SunflareSolarteam/004-H-01-SD-card-data-logger-PCB/README.md

# 004-H-01-SD-card-data-logger-PCB
Data logger for logging CAN bus data on SD card in the Sunflare solar boat
