SunflareSolarteam/004-H-01-SD-card-data-logger-PCB/Project Outputs for 004-H-01 SD data logger/004-H-01 SD data logger_Documentation.PDF

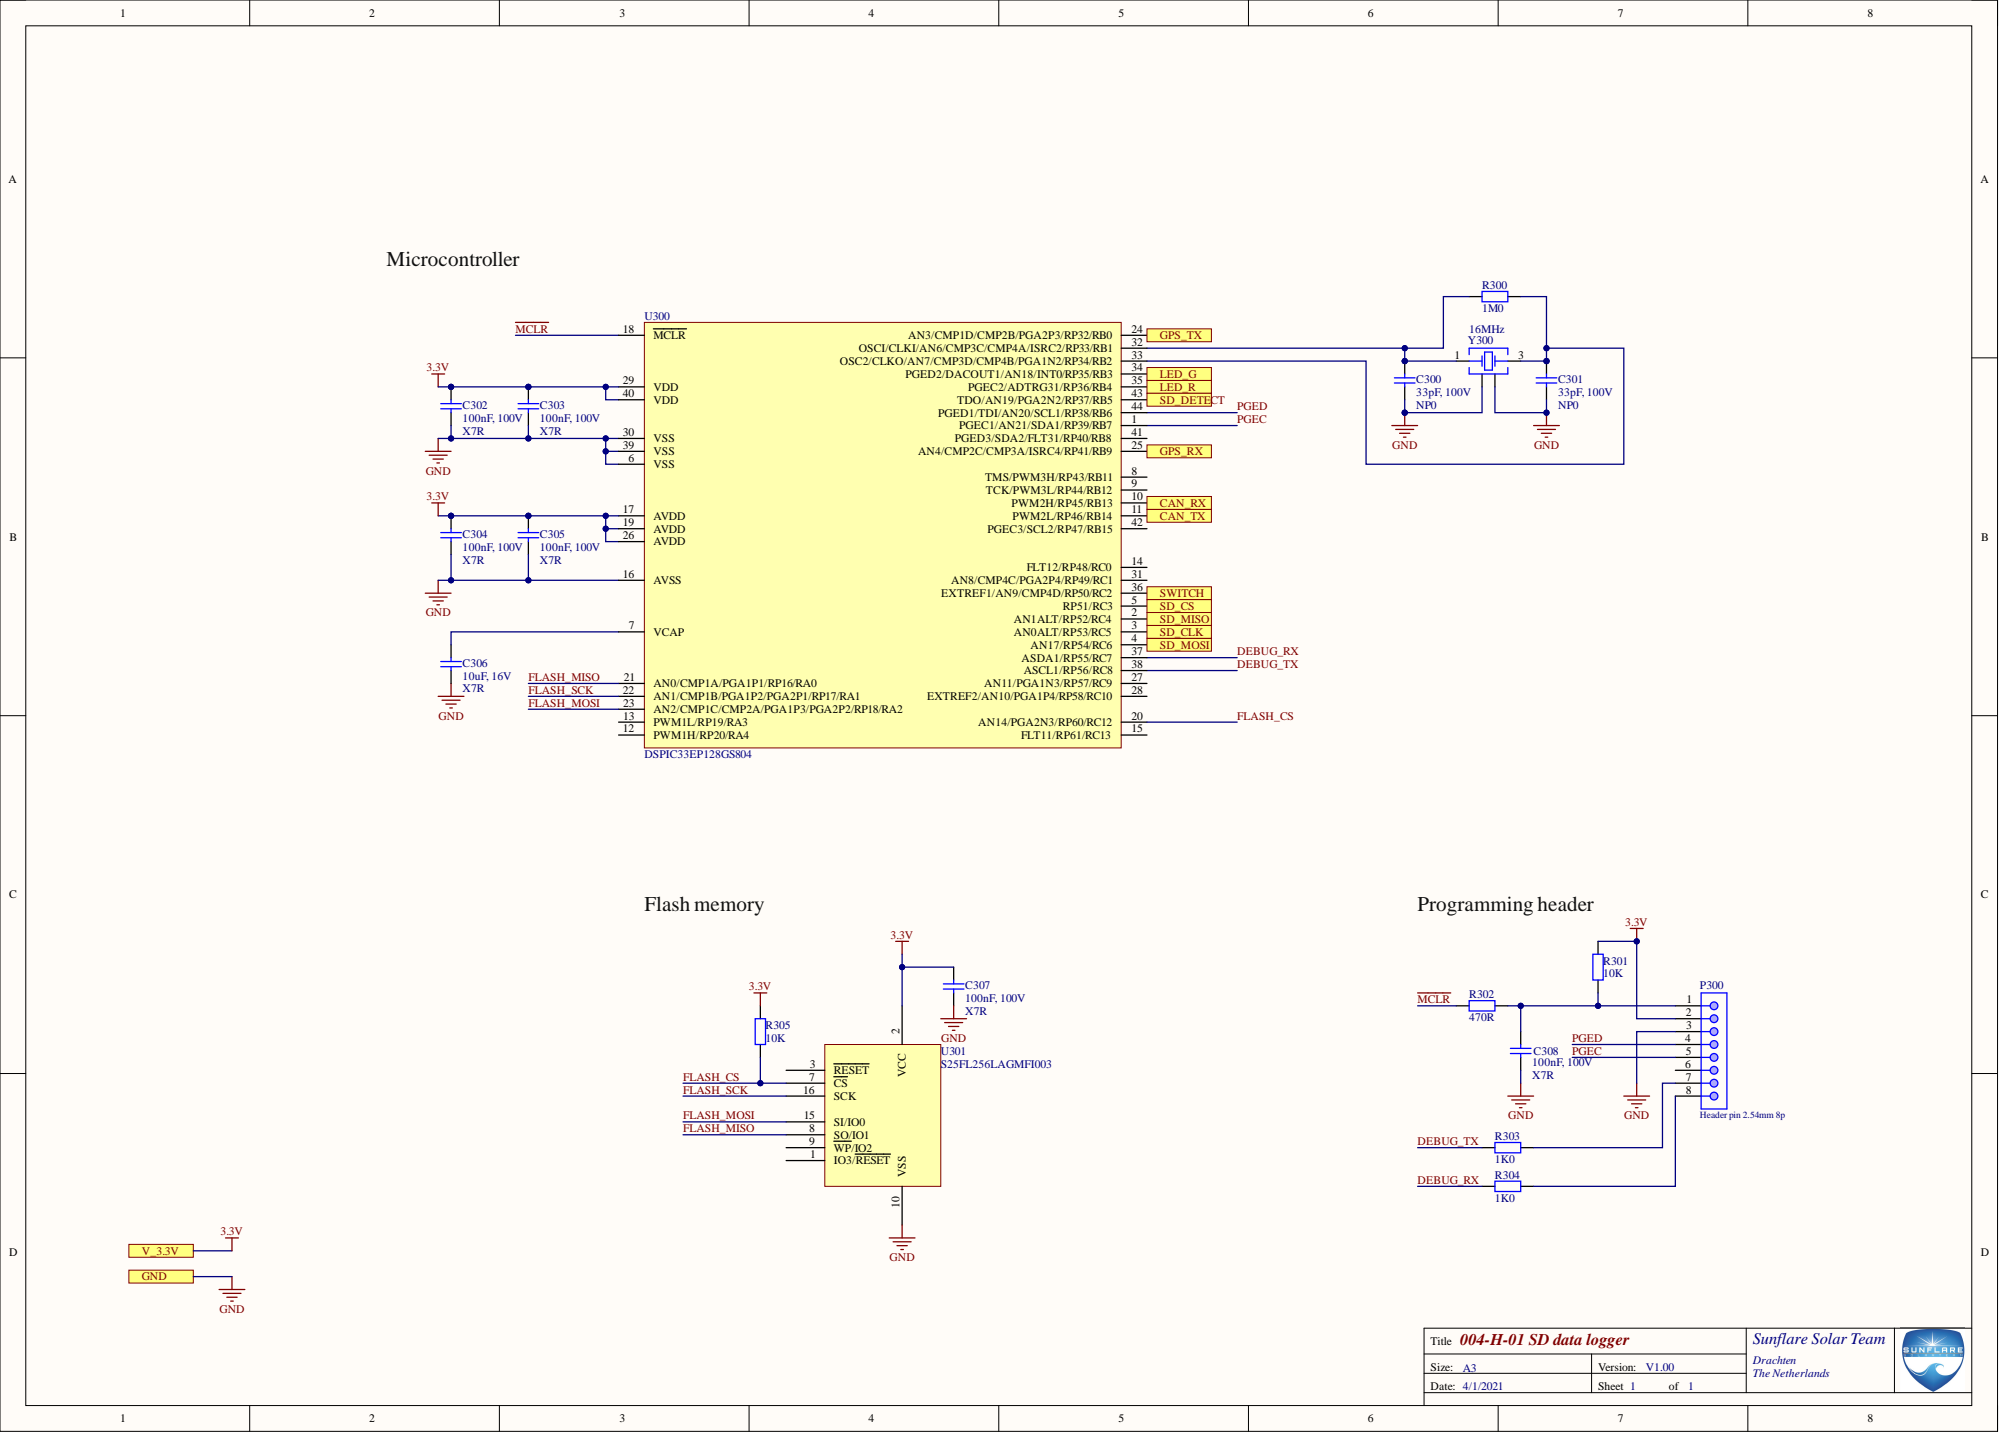
[picture p1: page 1]

3 9

1 9
2 6

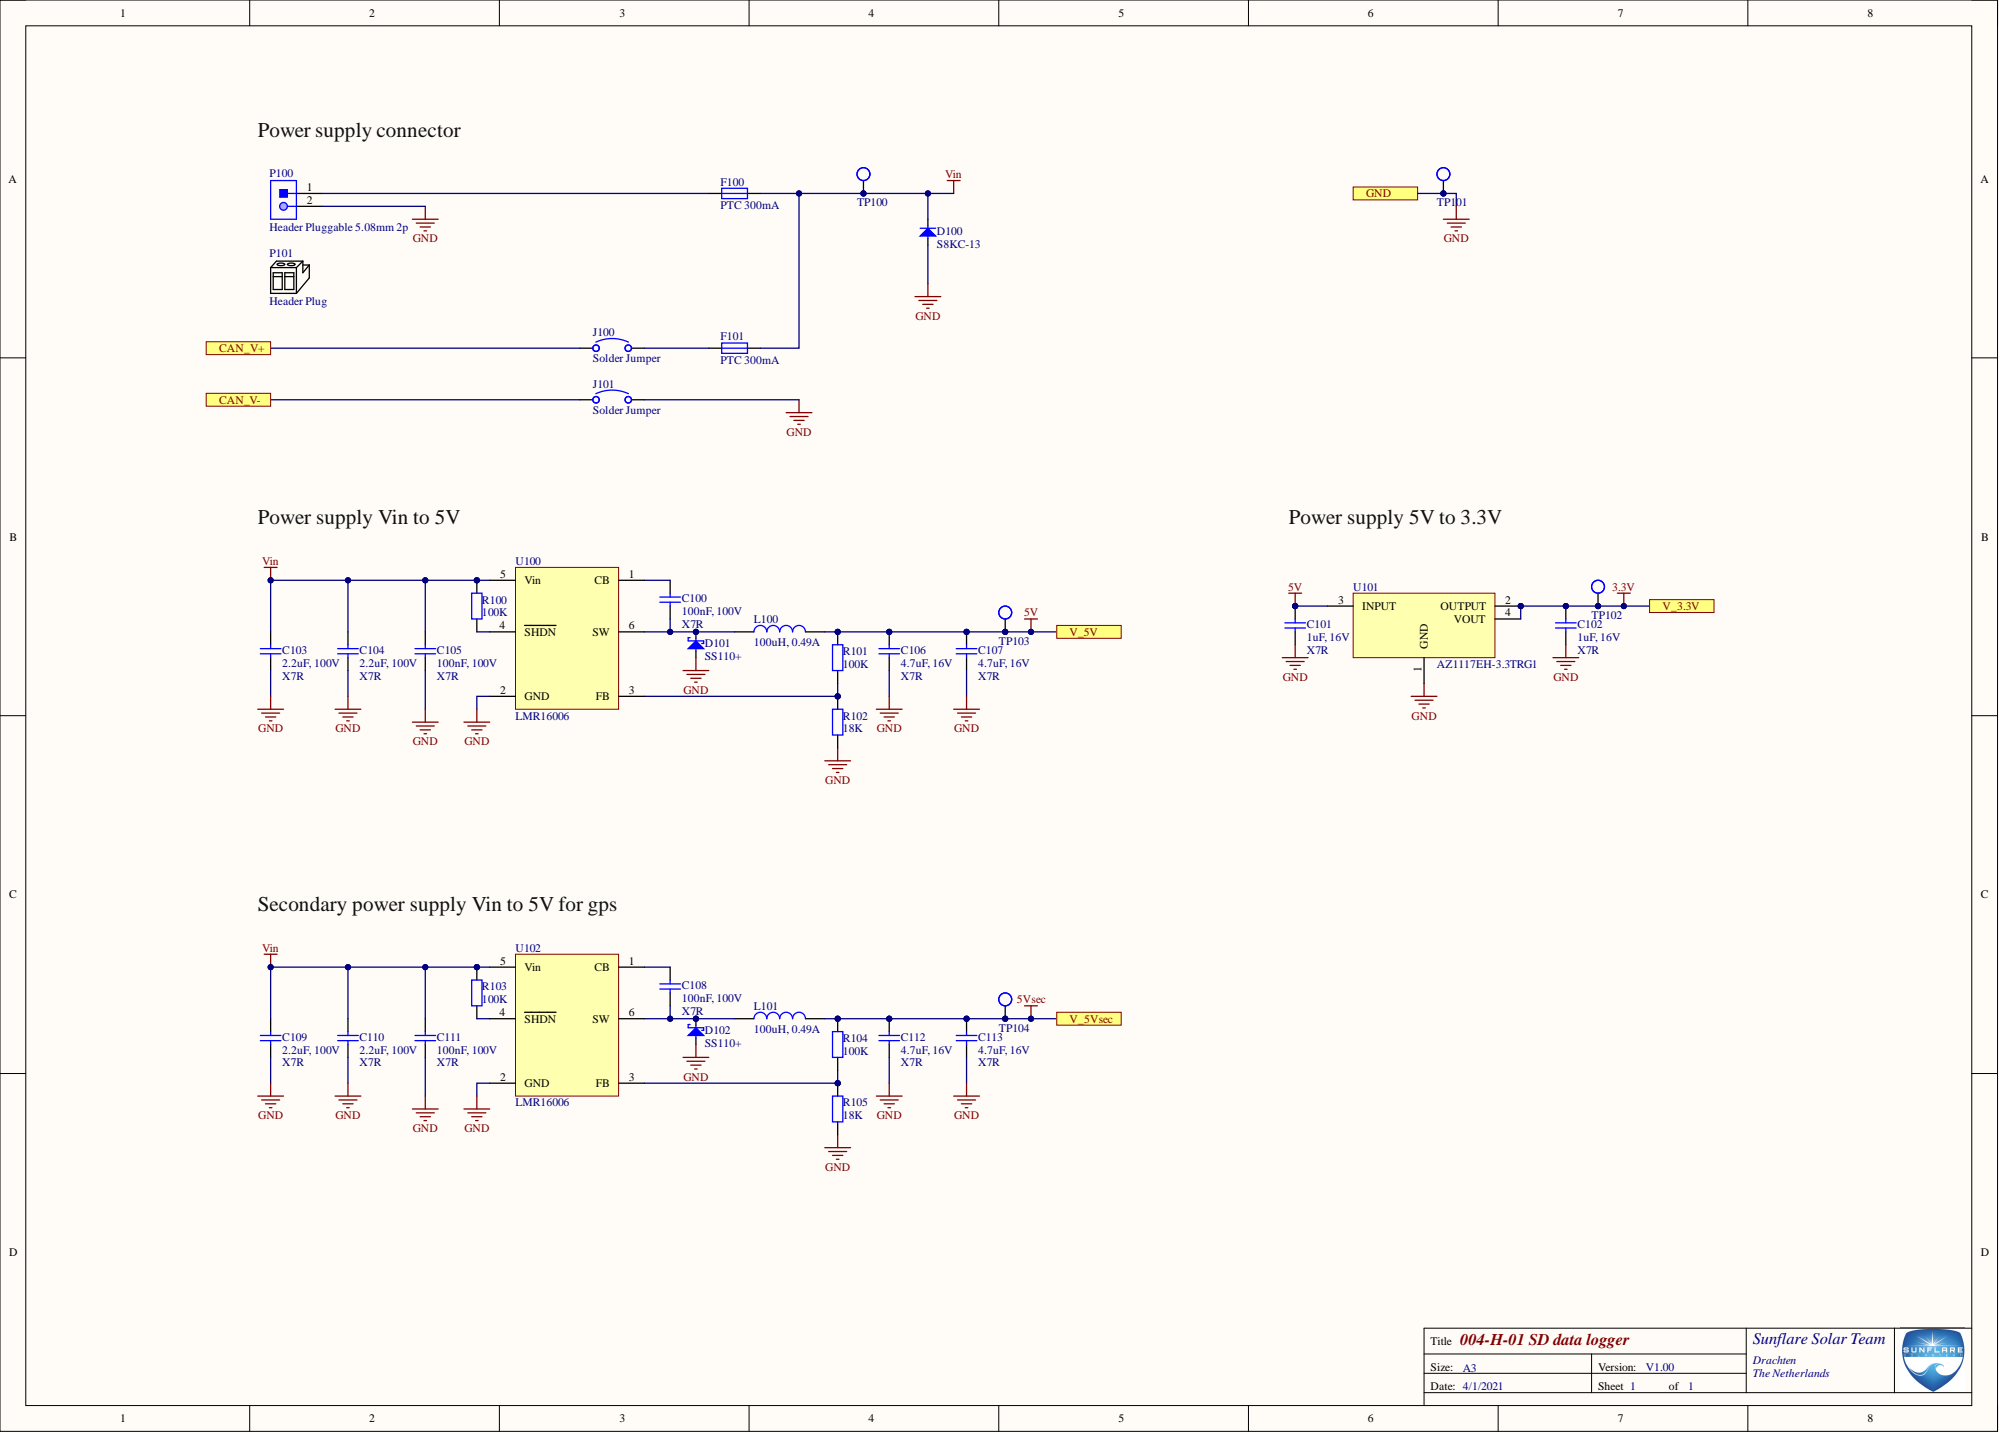
[picture p2: page 2]

Secondary power supply Vin to 5V for gps

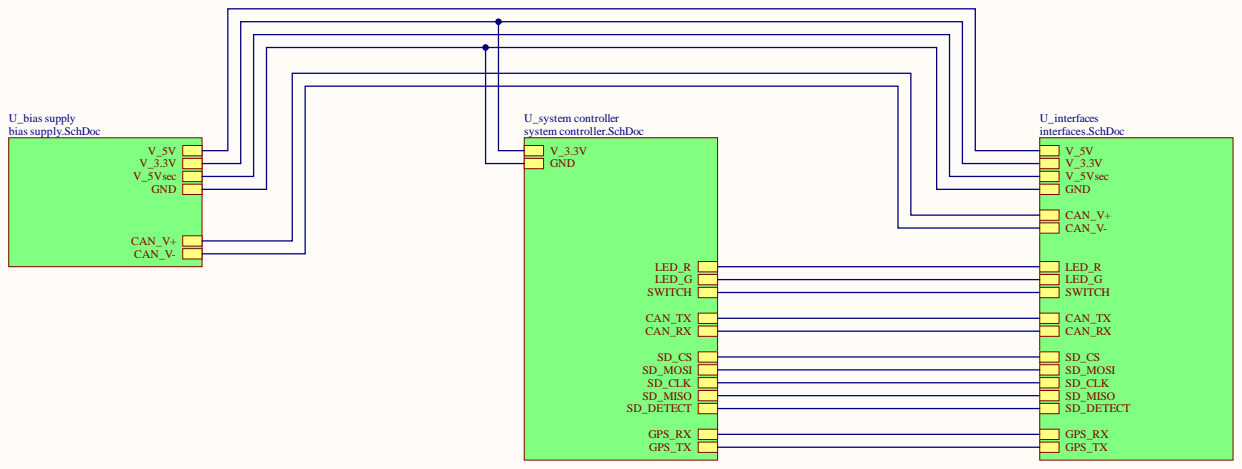
[picture p3: page 3]

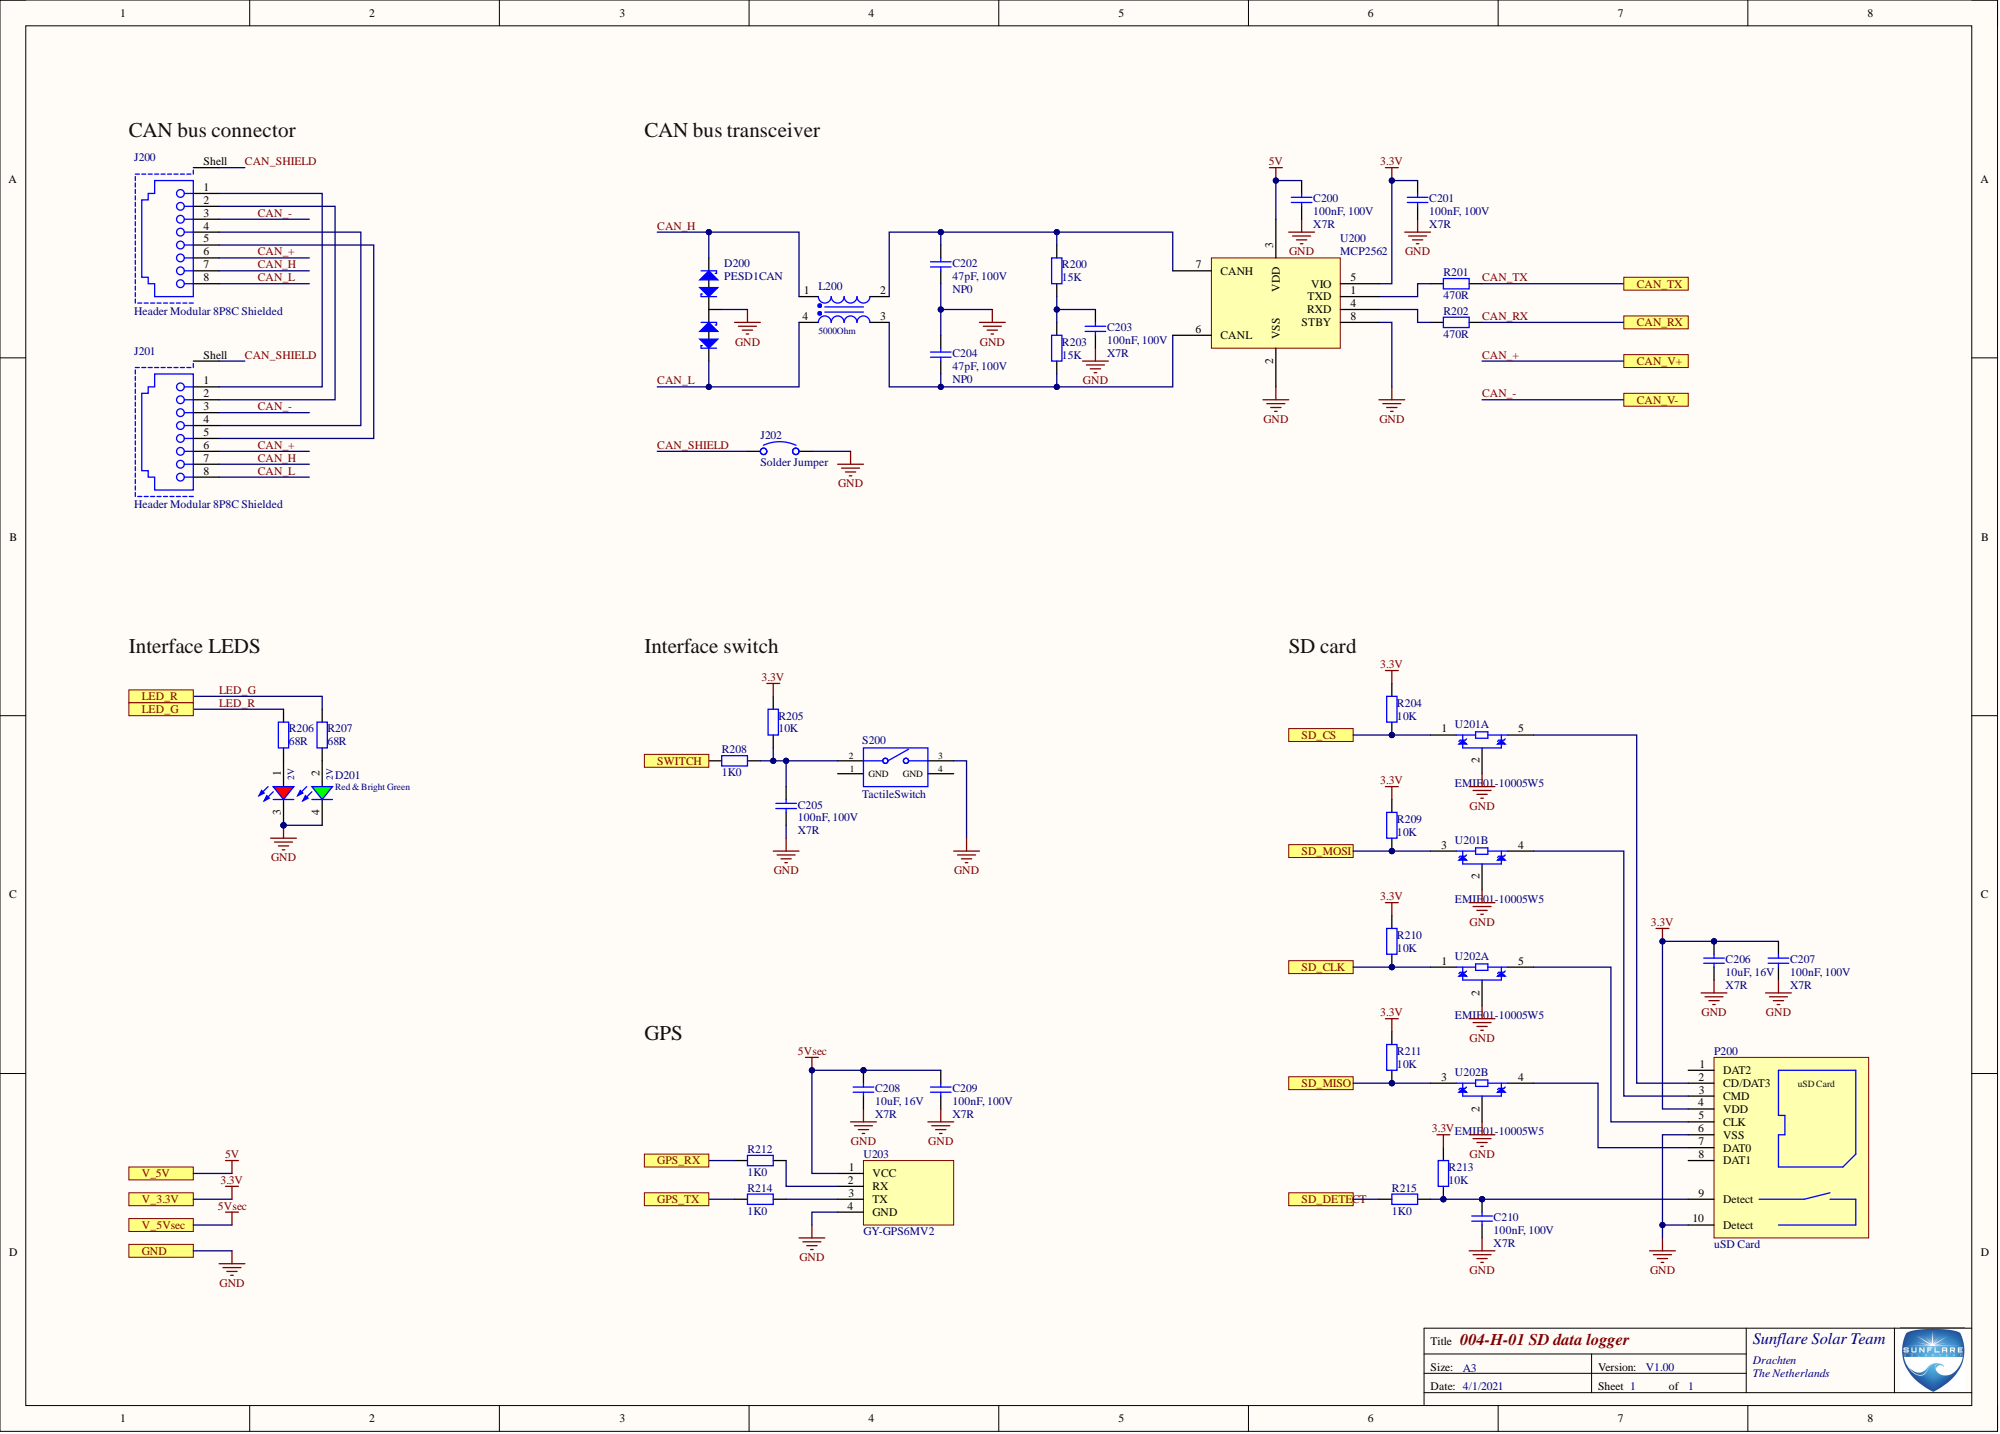
[picture p4: page 4]

D AT 2 CD / D AT 3 CMD

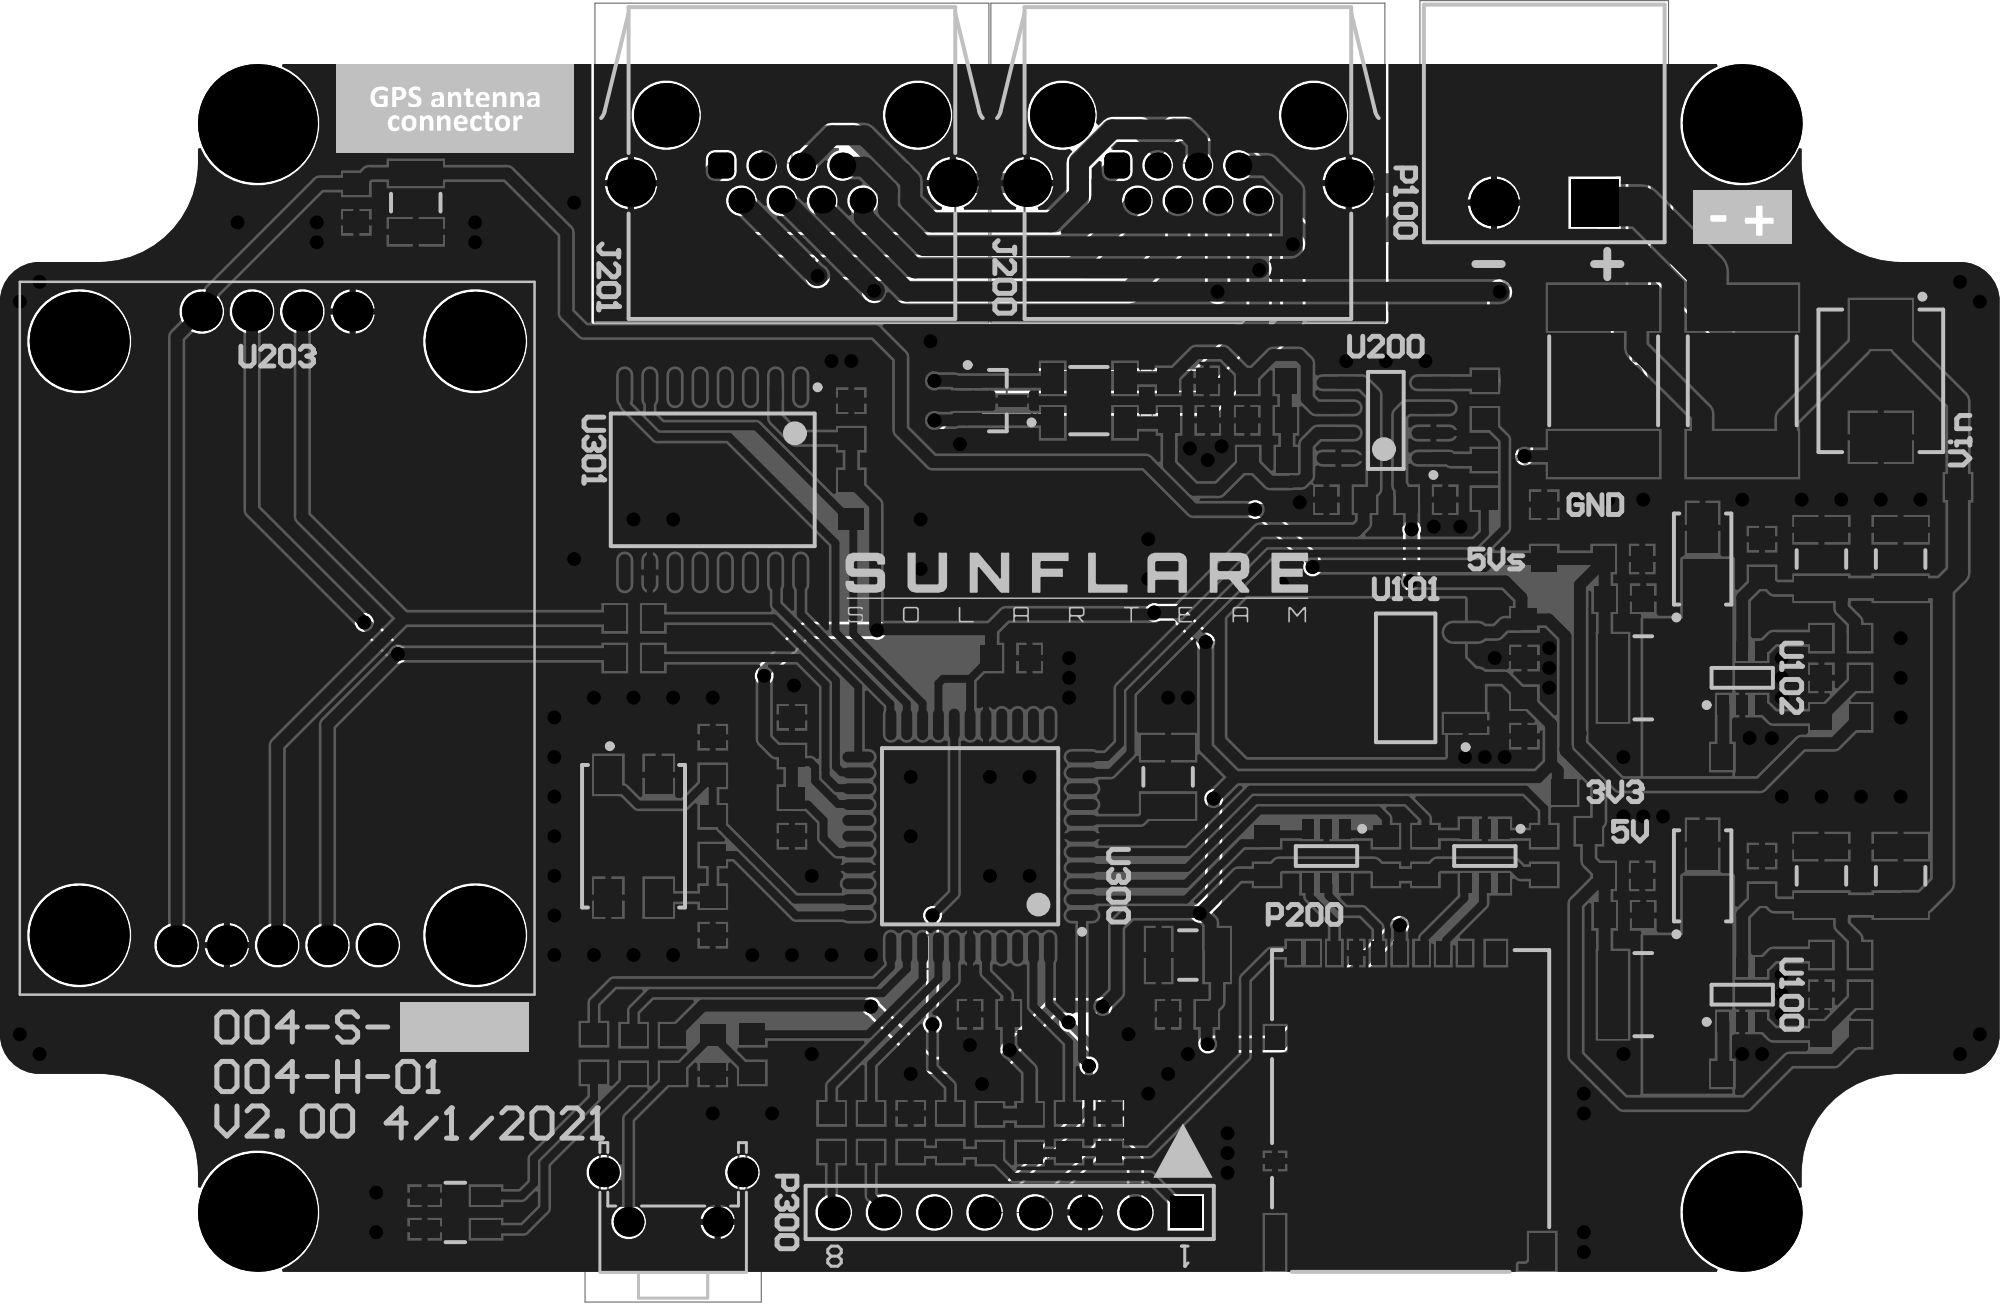
[picture p5: page 5]
