SunflareSolarteam/004-H-01-SD-card-data-logger-PCB/(list of files, drawings)

Other design files:
004-H-01 SD data logger cover.SchDoc
004-H-01 SD data logger.PcbDoc
004-H-01 SD data logger.PcbLib
004-H-01 SD data logger.PrjPcb
004-H-01 SD data logger.SchLib
bias supply.SchDoc
interfaces.SchDoc
system controller.SchDoc
