SunflareSolarteam/004-H-01-SD-card-data-logger-PCB/Project Outputs for 004-H-01 SD data logger/004-H-01 SD data logger_RealisticPrint.PDF

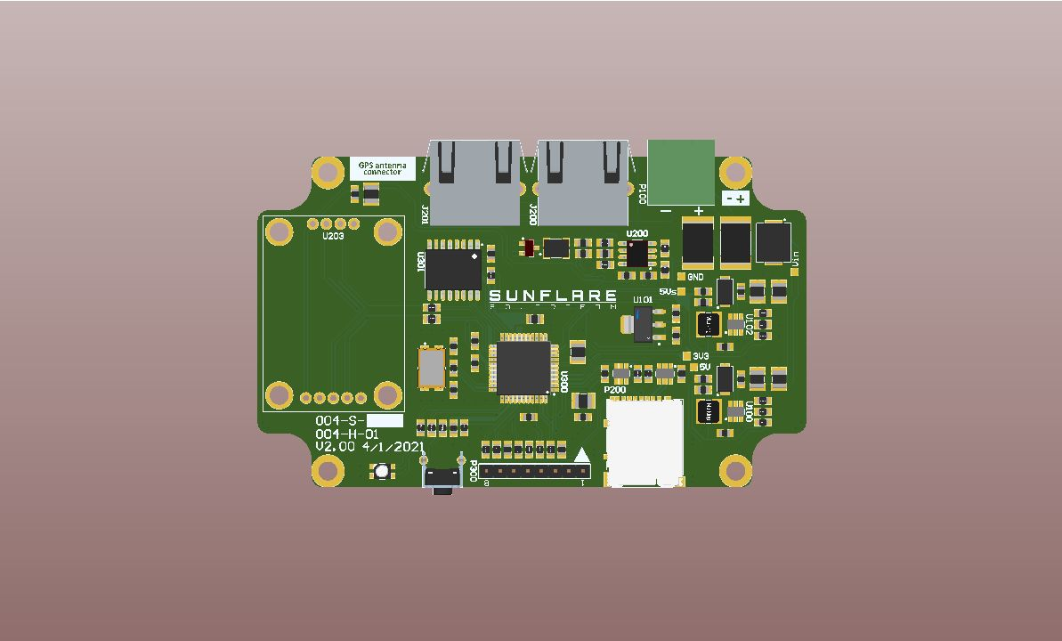
[picture p6: figure]

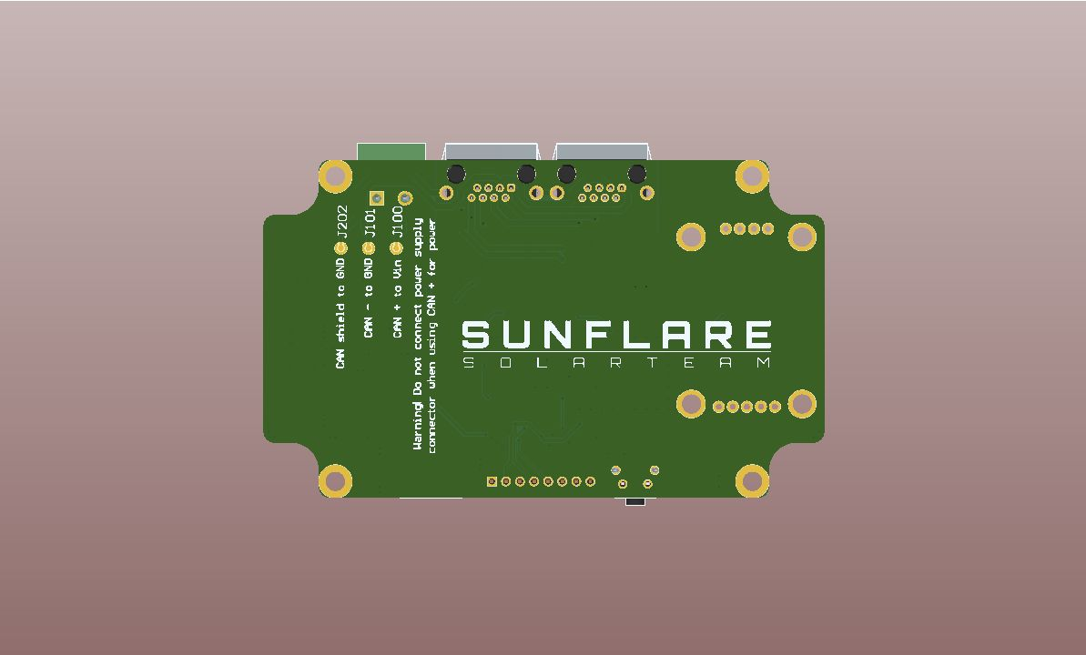
[picture p7: figure]
