SunflareSolarteam/004-H-01-SD-card-data-logger-PCB/(commit log)

2020-10-27 Initial commit
    Migration from local repos
    [004-H-01 SD data logger.GBL, 004-H-01 SD data logger.GBO, 004-H-01 SD data logger.GBP, 004-H-01 SD data logger.GBS, 004-H-01 SD data logger.GTL, 004-H-01 SD data logger.GTO, 004-H-01 SD data logger.GTP, 004-H-01 SD data logger.GTS]
2020-11-01 Changed rev to version
    [004-H-01 SD data logger.PcbDoc, 004-H-01 SD data logger.SchDoc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]
2021-03-25 Complete redesign
    Changed component library to mostly Wurth components.
    Fixed problem with broken power supply by removing buffer capacitors, adding flash chip for normal writing operations and adding additional power supply for gps.
    Put schematic on three pages.
    Redid layout.
    [004-H-01 SD data logger cover.SchDoc, 004-H-01 SD data logger.PcbDoc, 004-H-01 SD data logger.PcbLib, 004-H-01 SD data logger.PrjPcb, 004-H-01 SD data logger.SchDoc, 004-H-01 SD data logger.SchLib, bias supply.SchDoc, interfaces.SchDoc]
2021-03-31 Fixed unrouted nets
    Fixed unrouted nets.
    [004-H-01 SD data logger.PcbDoc]
2021-03-31 checked pcb and added comments
    [004-H-01 SD data logger.PcbDoc]
2021-04-01 Tweaked PCB design
    [004-H-01 SD data logger.GBL, 004-H-01 SD data logger.GBO, 004-H-01 SD data logger.GBP, 004-H-01 SD data logger.GBS, 004-H-01 SD data logger.GTL, 004-H-01 SD data logger.GTO, 004-H-01 SD data logger.GTP, 004-H-01 SD data logger.GTS]
2021-04-01 Fixed hardware number on pcb
    [004-H-01 SD data logger.GBL, 004-H-01 SD data logger.GBO, 004-H-01 SD data logger.GBP, 004-H-01 SD data logger.GBS, 004-H-01 SD data logger.GTL, 004-H-01 SD data logger.GTO, 004-H-01 SD data logger.GTP, 004-H-01 SD data logger.GTS]
2021-05-24 Improved Project outputs
    Added active BOM.
    Added Pick and Place.
    [004-H-01 SD data logger.GBL, 004-H-01 SD data logger.GBO, 004-H-01 SD data logger.GBP, 004-H-01 SD data logger.GBS, 004-H-01 SD data logger.GTL, 004-H-01 SD data logger.GTO, 004-H-01 SD data logger.GTP, 004-H-01 SD data logger.GTS]
